soundpaint/QuadCopHack/README.md

Hacking a Quadcop for Adding a Computer Controllable Interface
==============================================================

This project is for interested makers showing how to equip a low-cost
quadcop with a computer interface.

For more documentation, see also my [talk at GPN 18][1] (in German
language) as well as the corresponding slides as
[OpenDocument presentation (.odp) file][2] (in English language).

Features
--------

* Recording control lever movements and push button activities that
  are manually applied on the quadcop's remote control.

* Bypassing the remote control and thus replaying recorded movements
  and push button activities as if they were applied on the remote
  control.

* Status display of the remote control
  - as LED indicators directly on the hardware interface and
  - per software on the connected computer's display.

Hardware
--------

### Architectural Overview

The 15$ Quadcopter (incl. remote control), with added black multi-core
cable with Sub-D plug as electrical signal interface:

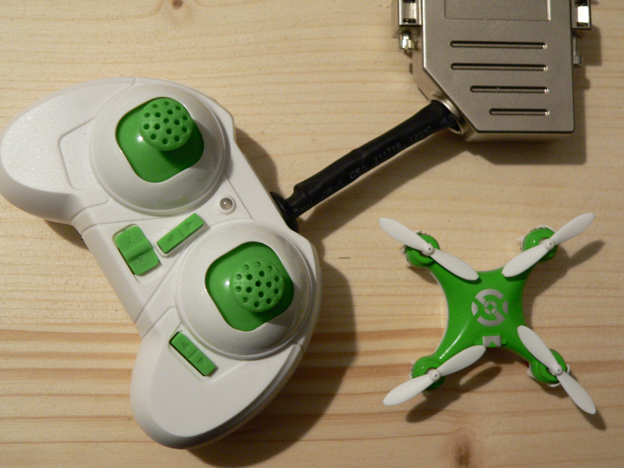
[picture p1: doc/images/img01.png]
Fig. 1: The 15$ Quadcop


**Fig. 1: The 15$ Quadcop**

<br />

The Sub-D plug interfaces the signal adapter panel.  This panel cares
for analog signal treatment such as electrical level adjustment and
amplification.  It also features a couple of LEDs for visualizing the
current signal status (see image top left).

The signal adapter panel itself interfaces an Arduino Mega 2560 board.
The Arduino cares for real-time conversion of incoming analog signals
to digital signals and driving analog output signals from digital
signals, as well as short-time buffering of digital signal values.  It
also annotates digital signal values with timestamp data (see image
top right).

Finally, the Arduino interfaces a Raspberry Pi 3 (see bottom right),
running the “QuadCopApp” application on a Raspbian GNU/Linux 9
(stretch) operating system.

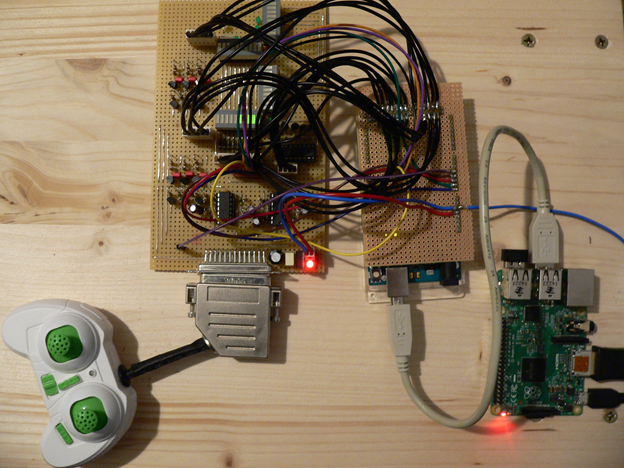
[picture p2: doc/images/img02.png]
Fig. 2 All building blocks at one glance


**Fig. 2: All building blocks at one glance**

<br />

### Remote Control

#### Pilot Stick Signal Tapping (1 out of 4)

Before surgery:

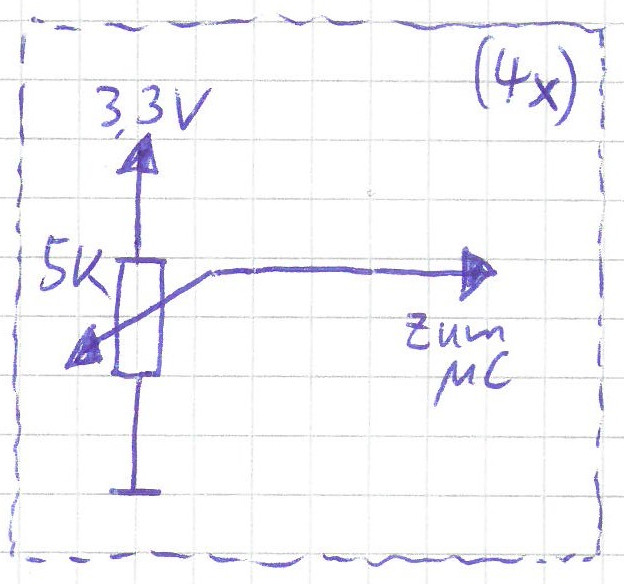
[picture p3: doc/images/img03.png]
Fig. 3 Pilot stick before surgery


**Fig. 3: Pilot stick before surgery**

<br />

After surgery:

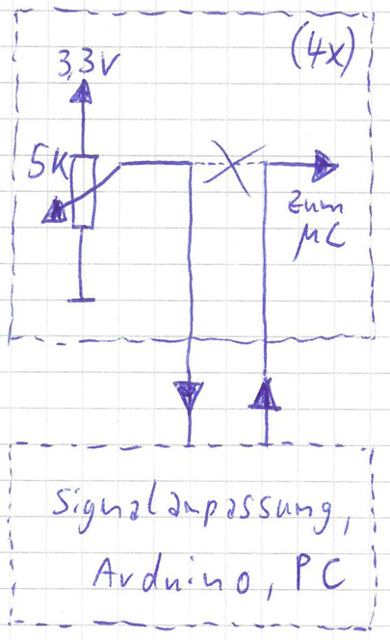
[picture p4: doc/images/img04.png]
Fig. 4 Pilot stick after surgery


**Fig. 4: Pilot stick after surgery**

<br />

Signal tapping directly at the pilot sticks’ potentiometers:

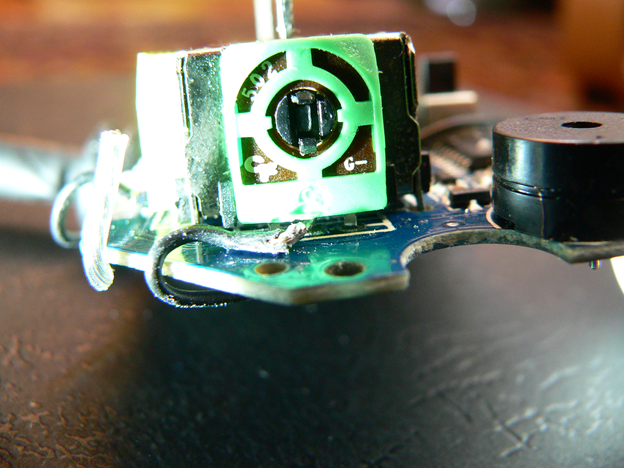
[picture p5: doc/images/img05.png]
Fig. 5a Potentiometer Signal Tapping


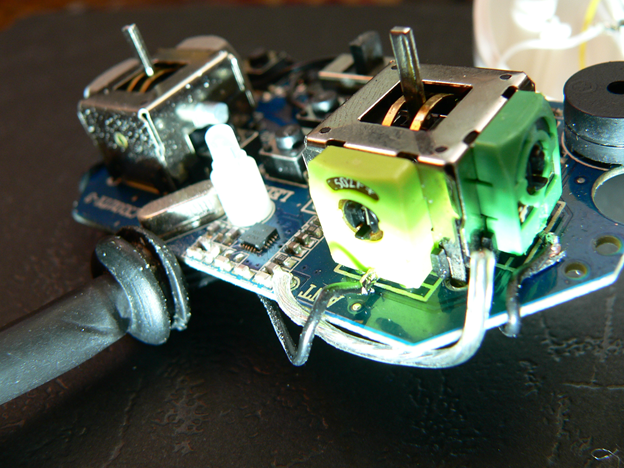
[picture p6: doc/images/img06.png]
Fig. 5b Potentiometer Signal Tapping


**Fig. 5: Potentiometer Signal Tapping**

<br />

#### Push Buttons Signal Tapping (1 out of 6), Original Design Approach

Before surgery:

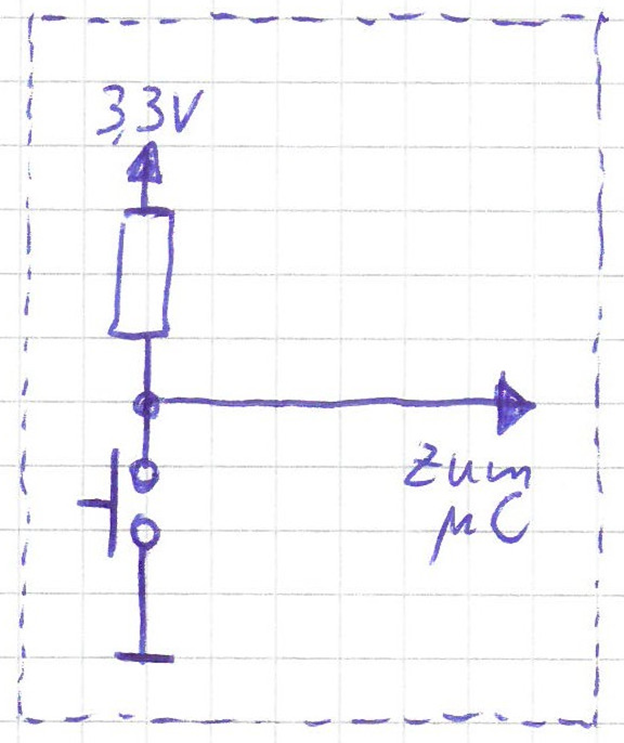
[picture p7: doc/images/img07.png]
Fig. 6 Button before Surgery


**Fig. 6 Button before Surgery**

<br />

After surgery:

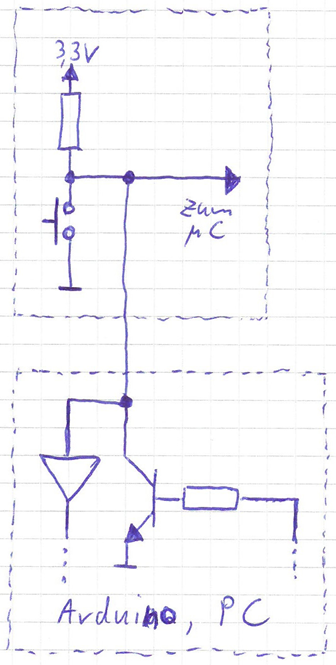
[picture p8: doc/images/img08.png]
Fig. 7 Button after Surgery


**Fig. 7 Button after Surgery**

<br />

Signal Tapping of Remote Control Push Buttons:

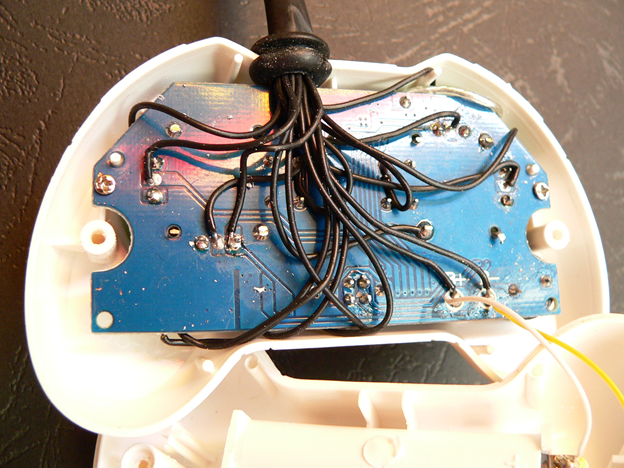
[picture p9: doc/images/img09.png]
Fig. 8a Button Signal Tapping


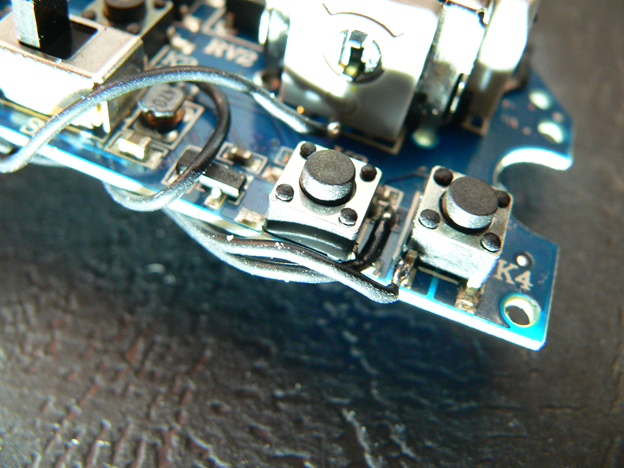
[picture p10: doc/images/img10.png]
Fig. 8b Button Signal Tapping


**Fig. 8 Button Signal Tapping**

<br />

#### Push Buttons Signal Tapping (1 out of 6), Final Design Approach

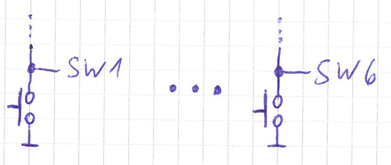
[picture p11: doc/images/img11.png]
Fig. 9 Button Signal Tapping Final Design Approach


**Fig. 9 Button Signal Tapping Final Design Approach**

<br />

Measured resistance values between button taps:

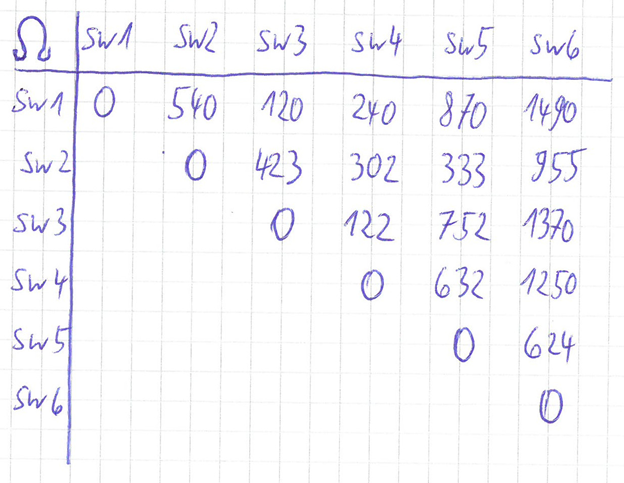
[picture p12: doc/images/img12.png]
Fig. 10 Measured Resistance Values


**Fig. 10 Measured Resistance Values**

<br />

Thereof derived reverse-engineered circuit design:

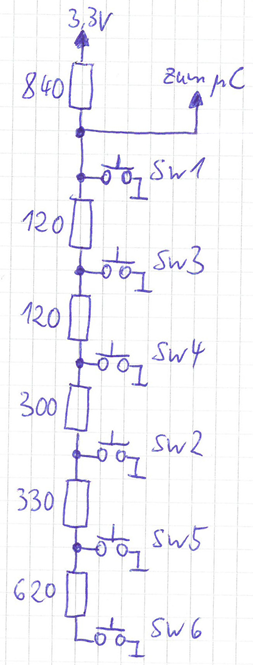
[picture p13: doc/images/img13.png]
Fig. 11 Derived Circuit Design


**Fig. 11 Derived Circuit Design**

<br />

#### Signal Routing

Signals (the black wires, added by me) are routed not parallel to the
transmission antenna (the thick silver wire at the right edge of the
printed board), but wired orthogonally to the antenna for minimizing
induction.  This way, we avoid effectively changing the size of the
antenna and thus the frequency and / or transmission quality:

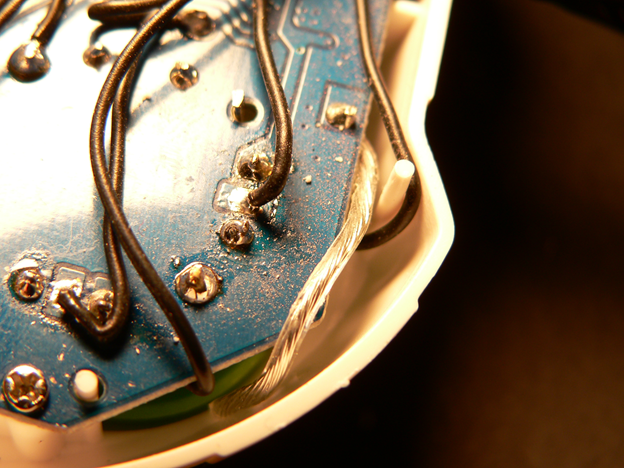
[picture p14: doc/images/img14.png]
Fig. 12 Signal Routing Around Antenna


**Fig. 12 Signal Routing Around Antenna**

<br />

#### Terminator Plug

So far, we basically have two types of modifications applied to the
remote control unit:

* just adding a wire that is soldered to some tapping point, but does
  not change the circuitry, and
* cutting an existing connection and leading out two open-ended wires
  that are soldered to the two cutting points.

For still keeping the remote control operational without additional
circuitry, we simply reconnect the open ends of the cut connections,
assuming that the resistance of the wires as well as induction issues
are neglectible.

To build a terminator for the open ended wired, we reconnect the open
ends by soldering small jumpers onto a female panel mount solder D-sub
connector plug:

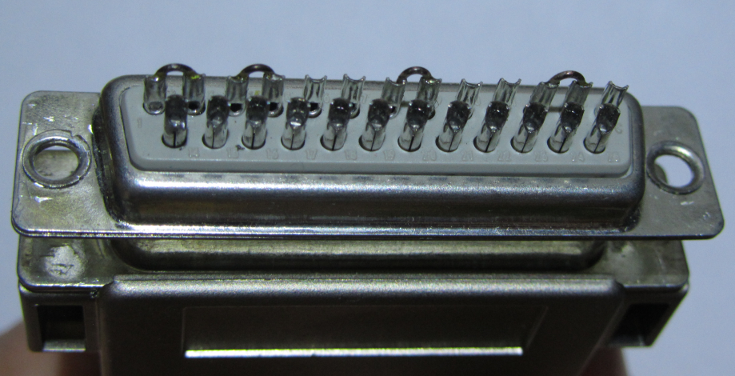
[picture p15: doc/images/img15.png]


**Fig. 13 Terminator plug**

<br />

When plugging this terminator into the male remote control's plug, the
cut connections are reconnected, and we can use the remote control
with no further hardware required.

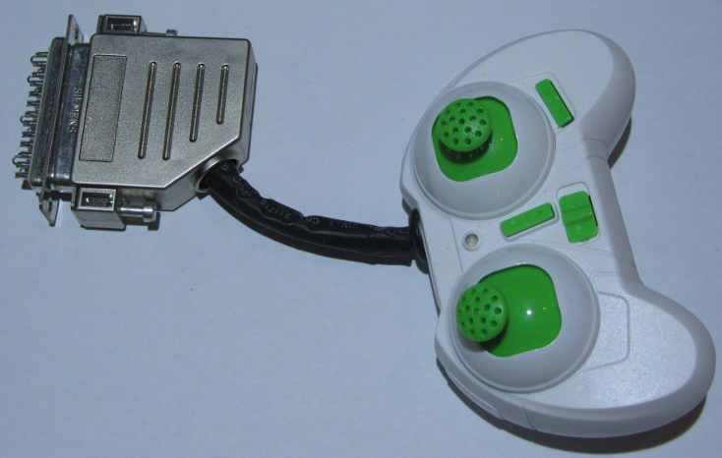
[picture p16: doc/images/img16.png]


**Fig. 14 Terminator plugged into remote control's plug**

<br />

### Analog Signal Conversion Board

View onto analog signal conversion board with LED bargraphs that
display pilot stick position, as well as remote control push button
status LEDs:

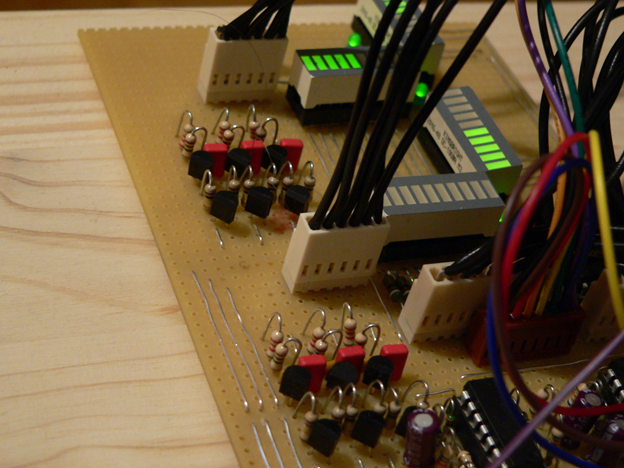
[picture p17: doc/images/img17.png]
Fig. 15a Analog Signal Conversion Board


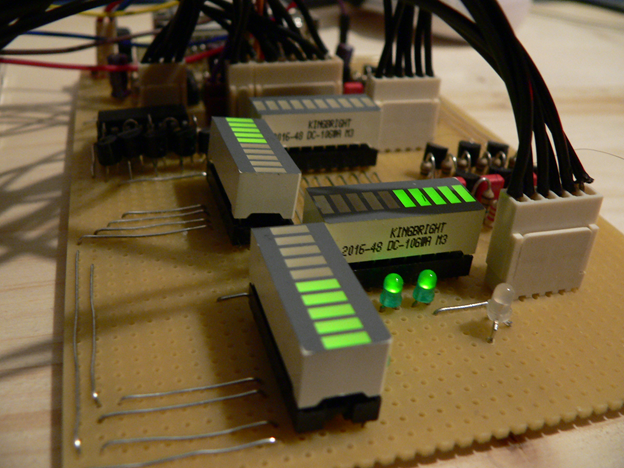
[picture p18: doc/images/img18.png]
Fig. 15b Analog Signal Conversion Board


**Fig. 15 Analog Signal Conversion Board**

<br />

#### Analog Signal Conditioning, Pilot Stick Axes (1 out of 4)

* Impedance conversion via OpAmp (voltage follower)
* Level adjustment to 3,3V (QuadCop) ⬌ 5V (Arduino) via voltage
  divider 68kΩ / 33kΩ
* 490Hz PWM signal smoothing via low pass filter, with cut-off
  frequency near-by 10Hz

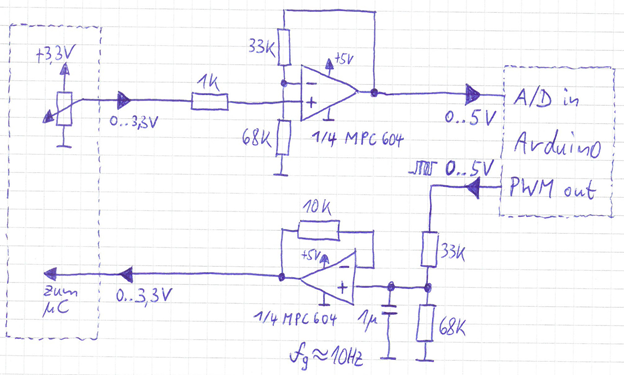
[picture p19: doc/images/img19.png]
Fig. 16 Analog Signal Conditioning


**Fig. 16 Analog Signal Conditioning**

<br />

#### Analog Signal Conditioning, Push Buttons

Common signal tap shared among all 6 push buttons:

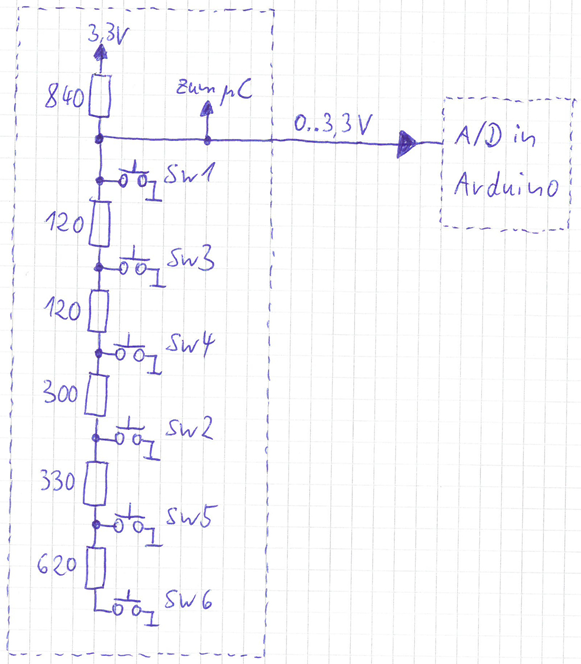
[picture p20: doc/images/img20.png]
Fig. 17 Common Push Buttons Tap


**Fig. 17 Common Push Buttons Tap**

<br />

Back signal (1 out of 6):

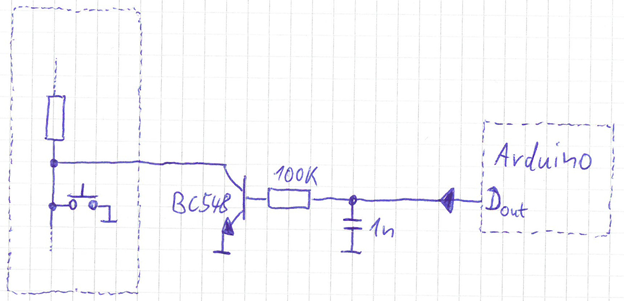
[picture p21: doc/images/img21.png]
Fig. 18 Push Button Back Signal


**Fig. 18 Push Button Back Signal**

<br />

#### LED Bargraph Display Matrix

The 74LS138 demultiplexer / decoder is used to address one row of the
matrix after the other in order to keep the number of required data
lines limited: D10..D11 are for selecting one of 5 rows of the matrix,
while D0..D9 carry the data for the selected row.  Consequently, the
software on the Arduino board must loop over the rows sufficiently
fast to achieve a flicker-free display.

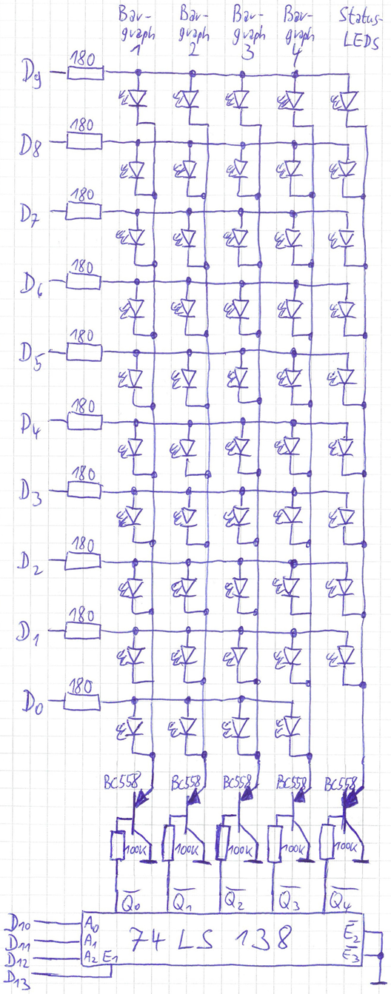
[picture p22: doc/images/img22.png]
Fig. 19 LED Bargraph Display Matrix


**Fig. 19 LED Bargraph Display Matrix**

<br />

#### Power Supply for Remote Control

Originally, the remote control is powered by two AAA type batteries,
resulting in a voltage of around 3V.  Internally, the remote control
(obviously) has a step-up voltage converter that converts the battery
power to a 3.3V level.

For valid operation, minimally the remote control's ground voltage
level has to be connected to our common ground voltage level, such
that all other voltage levels operate on a well-defined level.  I
decided to also replace the battery power with a 3.3V voltage
generated with a LD1117 3.3V voltage regulator powered from the
Arduino's 5V line.

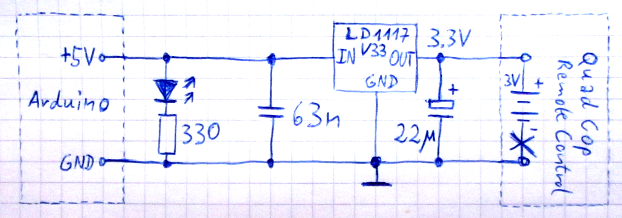
[picture p23: doc/images/img23.png]
Fig. 20 Power Supply for Remote Control


**Fig. 20 Power Supply for Remote Control**

<br />

#### Prototype wiring technique

I am using a somewhat unconventional technique of prototype wiring
with a (way to much) dissipative amount of solder.  You may laugh at
me, but it works!  Even when operating with high frequencies in the
tens-of-megahertz range (not really an issue for this project,
though).  And yes, you can recycle most of the solder for the next
project.

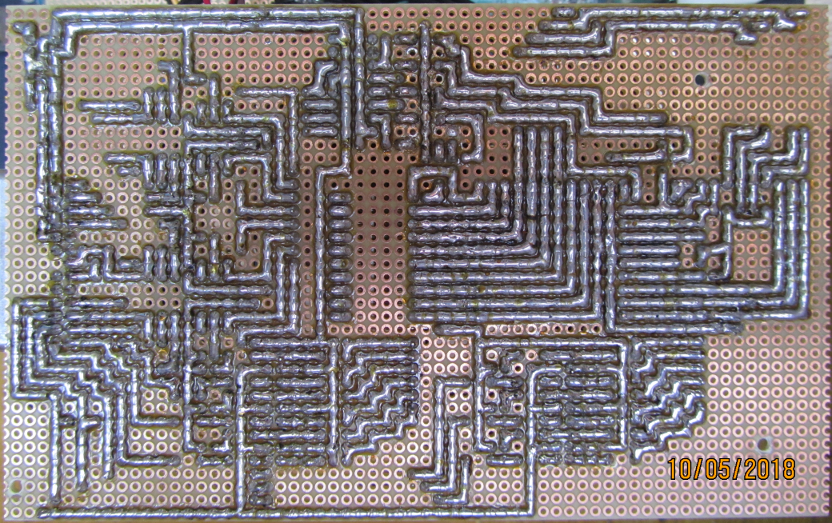
[picture p24: doc/images/img24.png]
Fig. 21 Prototype wiring technique


**Fig. 21 Prototype wiring technique**

<br />

### Arduino Board

An Arduino Mega 2560 Board hosts the software for realtime digital
flight control data recording, data serialization, data
deserialization, and analog flight control signal creation from
digital data.  Flight control data is transferred from and to the
Raspberry Pi board via serial data interface.

### Raspberry Pi Board

A Raspberry Pi 3 Board with Raspbian GNU/Linux 9 (stretch) operating
system hosts the Java Software “QuadCopApp” with Java Swing based GUI.
The software is used to persistently store and recall recorded flight
data, even at larger scale.  Not yet implemented but already
envisioned is also a flight data editor for either viewing and
modifying recorded flight data or even create flight data from
scratch.

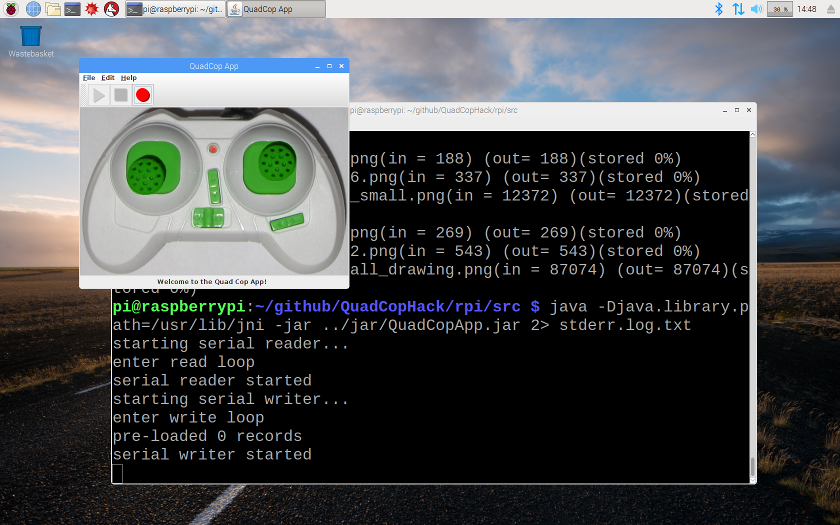
[picture p25: doc/images/img25.png]
Fig. 22 “QuadCopApp” Java Application


**Fig. 22 “QuadCopApp” Java Application**

<br />

Software
--------

Detailed documentation to be added.

### Arduino

#### Signal Layer: Signal Creation and Recording

##### Sampling

##### PWM

##### LED Display Driver

#### Digital Signal Treatment

#### Transport Layer: Interface Driver for Raspberry Pi

##### Serialization

##### Deserialization

##### Buffering

##### Synchronization

### Raspberry Pi

#### Compiling and Running the QuadCopApp Application

* Install a recent Raspbian version (such as Raspbian GNU/Linux 9
  (stretch)).

* Install the `RXTXcomm.jar` library.

  In order to run the `QuadCopApp` application, you need to have
  installed the _Java RXTX library_, typcially flying around as file
  `RXTXcomm.jar` e.g. in directory `/usr/share/java`.  If you have
  installed the _Arduino IDE_, you also may find it as part of the IDE
  installed files, e.g. as `/usr/share/arduino/lib/RXTXcomm.jar`.  If
  you can not find the file `RXTXcomm.jar` anywhere, try installing
  the library with the following command:

```console
$ sudo apt-get install librxtx-java
```

* Go to your Raspberry Pi's home directory:

```console
$ cd
```

* Clone all of the QuadCop software from github:

```console
$ git clone https://github.com/soundpaint/QuadCopHack.git
```

* Go to the directory with the Java `QuadCopApp` application:

```console
$ cd QuadCopHack/rpi/src
```

* Compile the Java `QuadCopApp` application:

```console
$ make all
```

* Provided all hardware components are correctly connected, you are
  now ready to run the Java `QuadCopyApp` application:

```console
$ java -Djava.library.path=/usr/lib/jni -jar ../jar/QuadApp.jar
```

* Make sure, that at startup of the `QuadCopApp` application, the
  arduino is up and connected via USB to the Raspberry Pi.  Otherwise,
  the `QuadCopApp` will show the error message “no serial port found”.

#### Transport Layer: Interface Driver for Arduino

##### Serialization

##### Deserialization

##### Buffering

##### Synchronization

#### Session Layer: Recording, Replaying and Persistent Storage

##### Recording

##### Replaying

##### Persistent Storage

#### Application Layer: The “QuadCopApp” Application

##### Session Control GUI

##### Graphical Flight Data Editor (not yet implemented)

[1]: https://media.ccc.de/v/gpn18-169-hacking-a-15-quadcop-for-adding-a-computer-interface-for-flight-control
[2]: ./doc/talk-gpn18/quadcop-talk.odp
