soundpaint/QuadCopHack/doc/talk-gpn18/img03.png

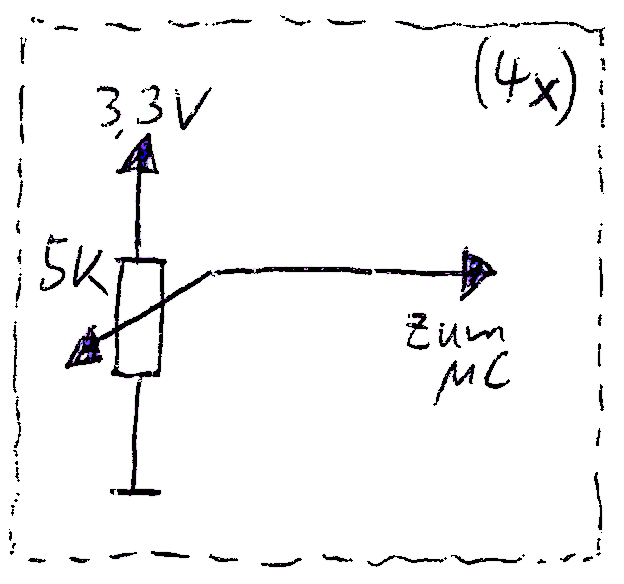
doc/talk-gpn18/img03.png
