soundpaint/QuadCopHack/doc/talk-gpn18/img07.png

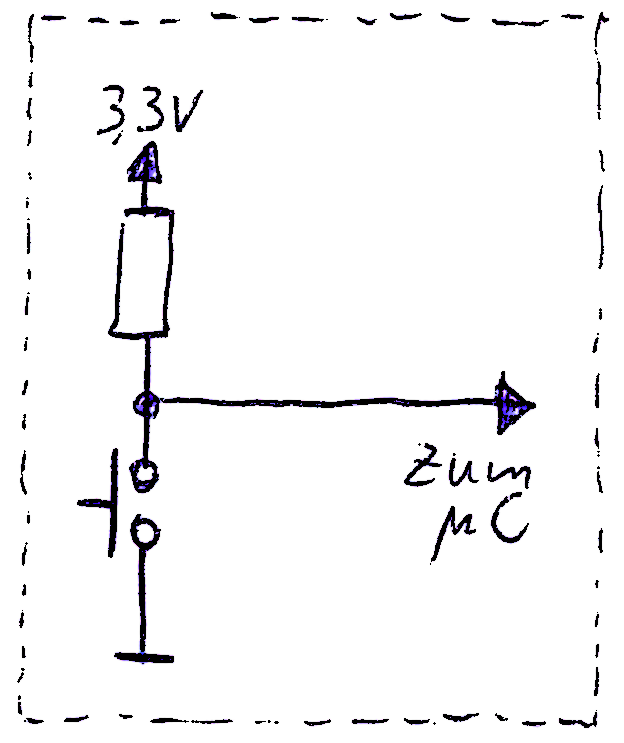
doc/talk-gpn18/img07.png
