soundpaint/QuadCopHack/doc/talk-gpn18/img08.png

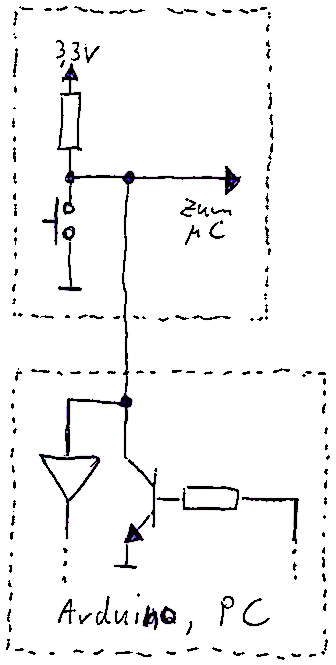
doc/talk-gpn18/img08.png
