soundpaint/QuadCopHack/doc/talk-gpn18/img11.png

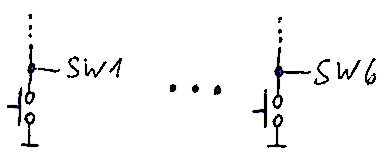
doc/talk-gpn18/img11.png
