soundpaint/QuadCopHack/doc/talk-gpn18/img12.png

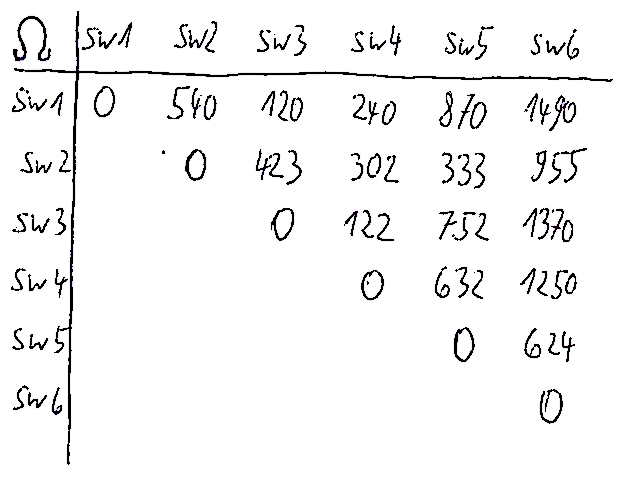
doc/talk-gpn18/img12.png
