soundpaint/QuadCopHack/doc/talk-gpn18/img17.png

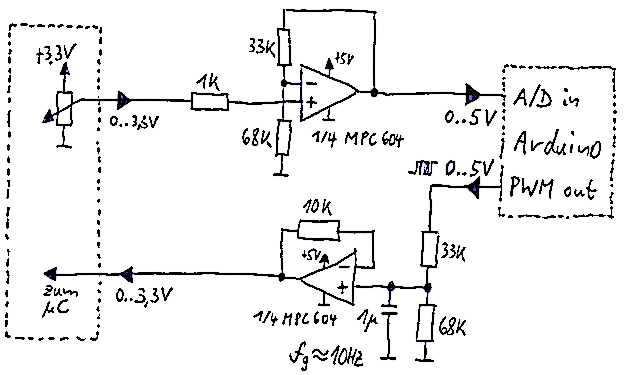
doc/talk-gpn18/img17.png
