soundpaint/QuadCopHack/doc/talk-gpn18/img18.png

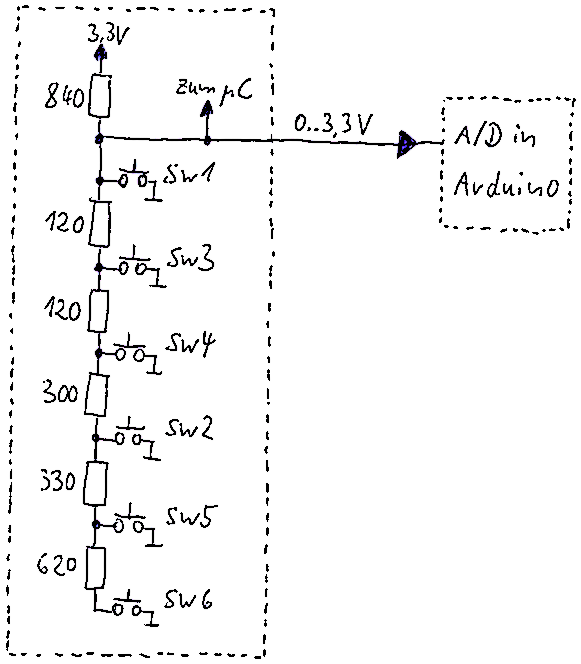
doc/talk-gpn18/img18.png
