soundpaint/QuadCopHack/doc/talk-gpn18/img19.png

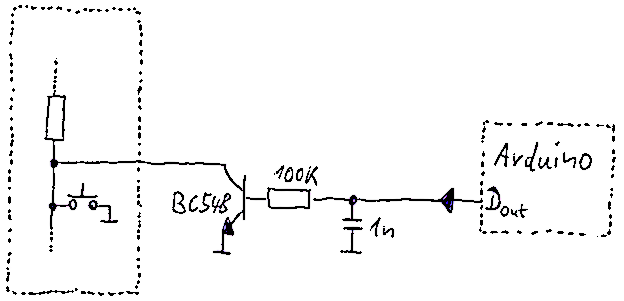
doc/talk-gpn18/img19.png
