soundpaint/QuadCopHack/doc/talk-gpn18/img21.png

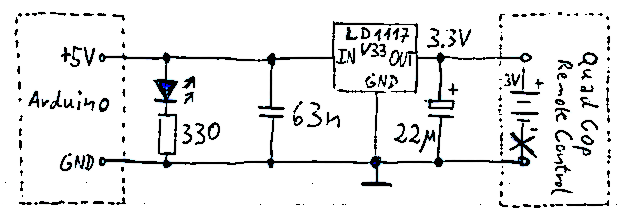
doc/talk-gpn18/img21.png
