soundpaint/QuadCopHack/rpi/src/images/quadcop_small.png

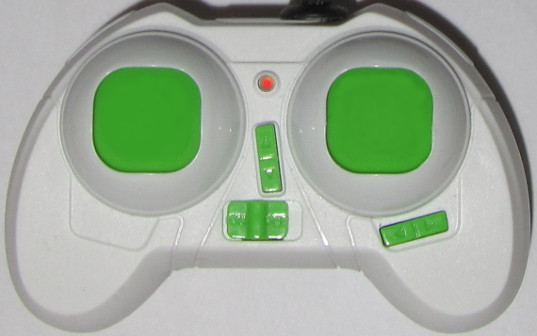
rpi/src/images/quadcop_small.png
