soundpaint/QuadCopHack/rpi/src/images/quadcop_small_drawing.png

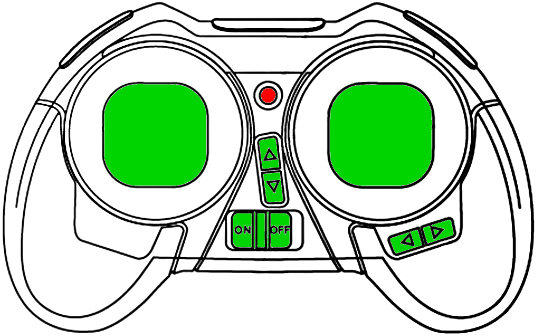
rpi/src/images/quadcop_small_drawing.png
